bg4uvr/Navigation-GPS/doc/M8_240128_GPS.pdf

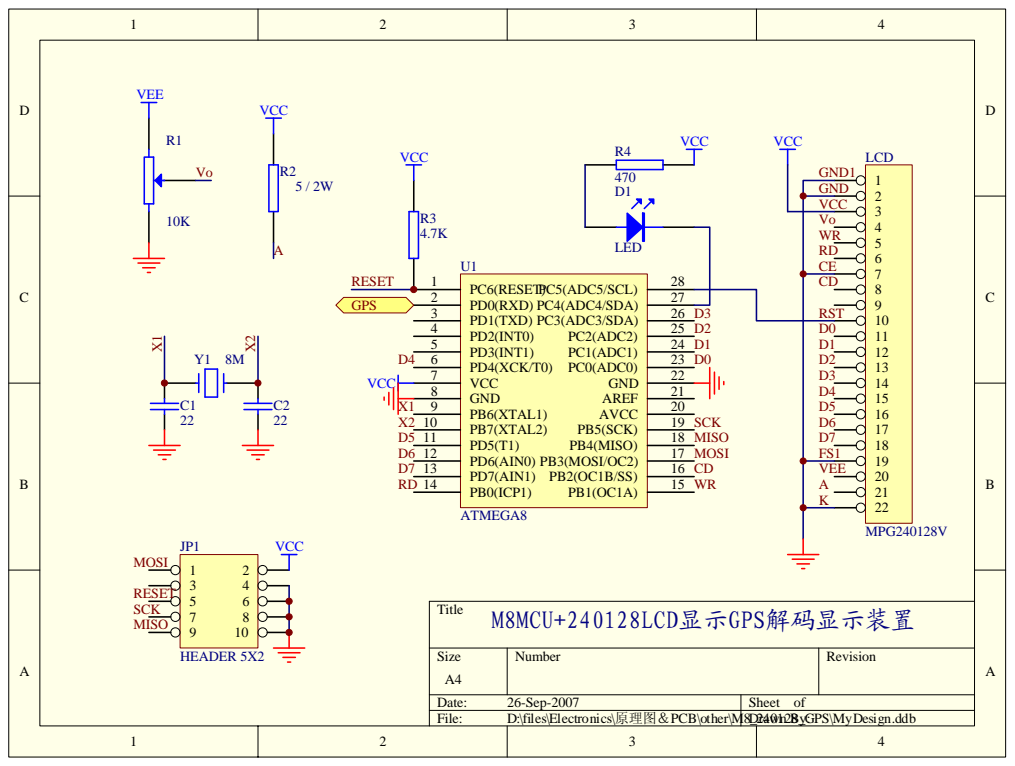
[picture p3: page 1]

Date: 26-Sep-2007 | Sheet of
File: D:\files\Electronics\原理图＆PCB\other\M8_240128_GPS\MyDesign.ddb Drawn By:
